pndv/pndv.github.io/content/posts/reducing-e-waste.md

---
title: "Reducing E Waste"
date: 2022-06-01T20:01:32-07:00
draft: false
categories:
  - opinion
  - technology
  - legal
tags:
  - e-waste
  - right-to-repair
  - open-source
---

Besides Right-to-Repair, a supplementary and much easier law to enact will be to require companies to make public 
all schematics, bill-of-material, source code, CAD designs for the deprecated products; i.e. the products which are 
no longer sold, repaired, and for even the replacement parts are no longer manufactured. 

This is not only good for environment, but also enables the general public to keep using the products they own for 
as long as they wish. This is in line with the copyright and patent laws, wherein the patents and copyrights expire 
after a certain time.
