pndv/pndv.github.io/content/posts/not-living-in-matrix.md

---
title: "We are NOT Living in the Matrix"
date: 2022-07-04T19:35:53-07:00
draft: false
categories:
    - random
    - movies
tags:
    - matrix
    - movies
---

I postulate that we are not living in the Matrix. If we were living in a world rule by intelligent machines, then 
the machines would have lobotomised the human beings to a vegetative state. The only reason for keeping humans was 
to harness the electricity/heat from their bodies, for this purpose they wouldn't need an actively thinking human 
who can potentially collapse the whole existence of machines'. 

The machines, if they were intelligent, would have guessed quickly that they don't need to take the trouble of 
building a fake reality, in which people are mostly happy, to imprison them.
