pndv/pndv.github.io/content/posts/fixing-coolscan-8000/ShaftCollar-TK156-005-CoolScan-8000/ShaftCollar-TK156-005-CoolScan-8000.step

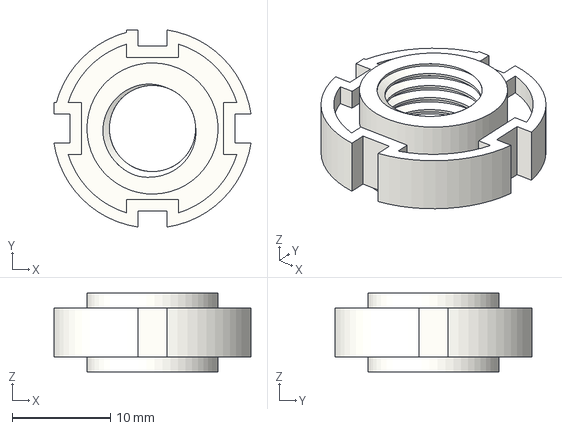
[picture p4: CAD file, 2022-07-19]
content/posts/fixing-coolscan-8000/ShaftCollar-TK156-005-CoolScan-8000/ShaftCollar-TK156-005-CoolScan-8000.step
20.1 x 20.1 x 8.00 mm
