pndv/pndv.github.io/(list of files, cad)

Other CAD files:
content/posts/fixing-coolscan-8000/ShaftCollar-TK156-005-CoolScan-8000/ShaftCollar-TK156-005-CoolScan-8000.f3d
content/posts/fixing-coolscan-8000/ShaftCollar-TK156-005-CoolScan-8000/ShaftCollar-TK156-005-CoolScan-8000.stl
