pndv/pndv.github.io/(commit log)

2022-07-19 Post Nikon CoolScan 8000 fixing (#1)
    * Post about fixing Nikon CoolScan 8000
    [ShaftCollar-TK156-005-CoolScan-8000.f3d, ShaftCollar-TK156-005-CoolScan-8000.step, ShaftCollar-TK156-005-CoolScan-8000.stl]
2022-08-07 Fix post and images
    [ShaftCollar-TK156-005-CoolScan-8000.f3d, ShaftCollar-TK156-005-CoolScan-8000.step, ShaftCollar-TK156-005-CoolScan-8000.stl]
